simeste/IQRF-Smart-City/README.md

# IQRF Smart City / Smartby
IQRF Smart City prosjekt på NTNU i Gjøvik.

Les manualen for å forstå hvordan byen fungerer.
