simeste/IQRF-Smart-City/Streetlights/Circuit/pcb/pdf.pdf

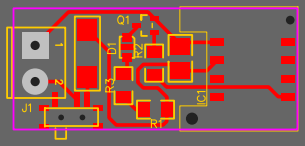
[picture p1: figure]
