simeste/IQRF-Smart-City/Trafficlights/Circuit/EW - 1SHR/pcb/dxf.dxf

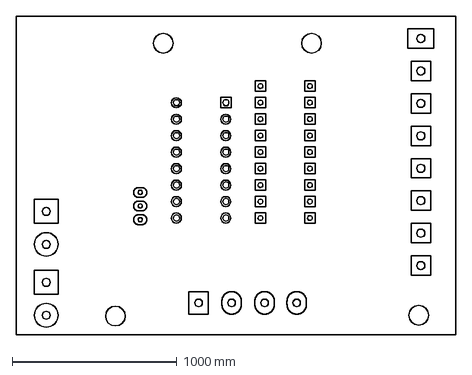
[picture p2: CAD file, 2019-11-27]
Trafficlights/Circuit/EW - 1SHR/pcb/dxf.dxf
2669.0 x 1930.0 mm
