simeste/IQRF-Smart-City/Trafficlights/Circuit/NS - 2SHR/pcb/dxf.dxf

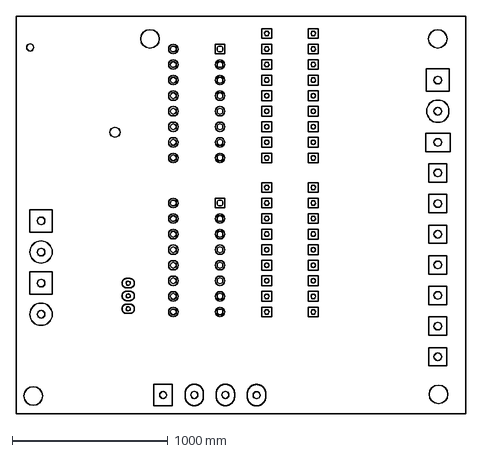
[picture p3: CAD file, 2019-11-27]
Trafficlights/Circuit/NS - 2SHR/pcb/dxf.dxf
2890.0 x 2556.0 mm
