simeste/IQRF-Smart-City/Doorlock/Circuit/pcb/dxf.dxf

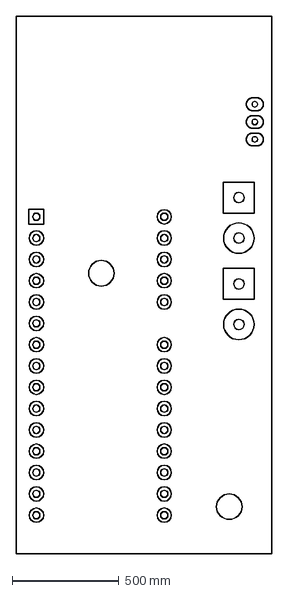
[picture p4: CAD file, 2019-11-27, an earlier design]
Doorlock/Circuit/pcb/dxf.dxf
1200.0 x 2520.0 mm
