simeste/IQRF-Smart-City/Parking Lot/Screen/Circuit/pcb/dxf.dxf

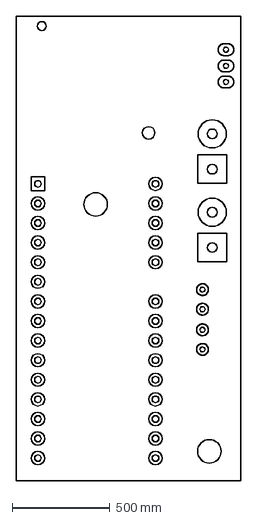
[picture p5: CAD file, 2019-11-27, an earlier design]
Parking Lot/Screen/Circuit/pcb/dxf.dxf
1145.0 x 2370.0 mm
