simeste/IQRF-Smart-City/Parking Lot/Space/Circuit/pcb/dxf.dxf

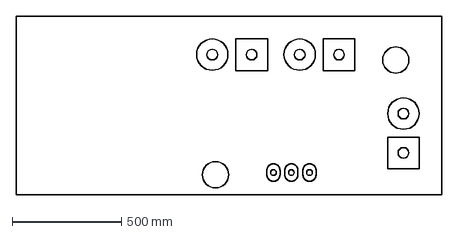
[picture p6: CAD file, 2019-11-27, an earlier design]
Parking Lot/Space/Circuit/pcb/dxf.dxf
1949.0 x 818.0 mm
