simeste/IQRF-Smart-City/Streetlights/Circuit/pcb/dxf.dxf

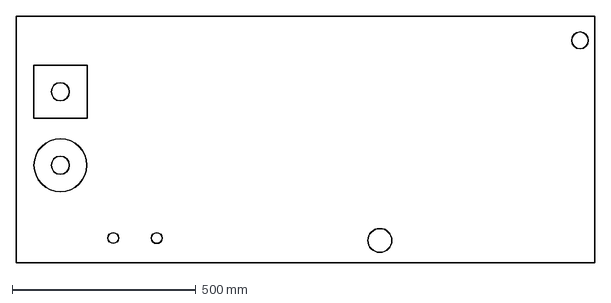
[picture p7: CAD file, 2019-11-27, an earlier design]
Streetlights/Circuit/pcb/dxf.dxf
1575.0 x 670.0 mm
