simeste/IQRF-Smart-City/Temperature Room/Circuit/pcb/Temperature sensor/dxf.dxf

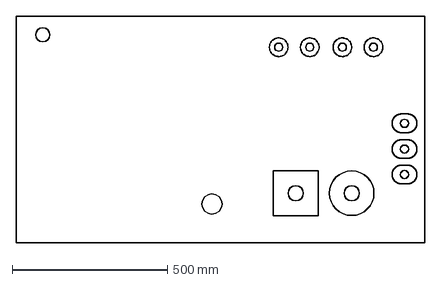
[picture p8: CAD file, 2019-11-27, an earlier design]
Temperature Room/Circuit/pcb/Temperature sensor/dxf.dxf
1315.0 x 730.0 mm
