simeste/IQRF-Smart-City/Trafficlights/Circuit/EW - 1SHR/schematics/pdf.pdf

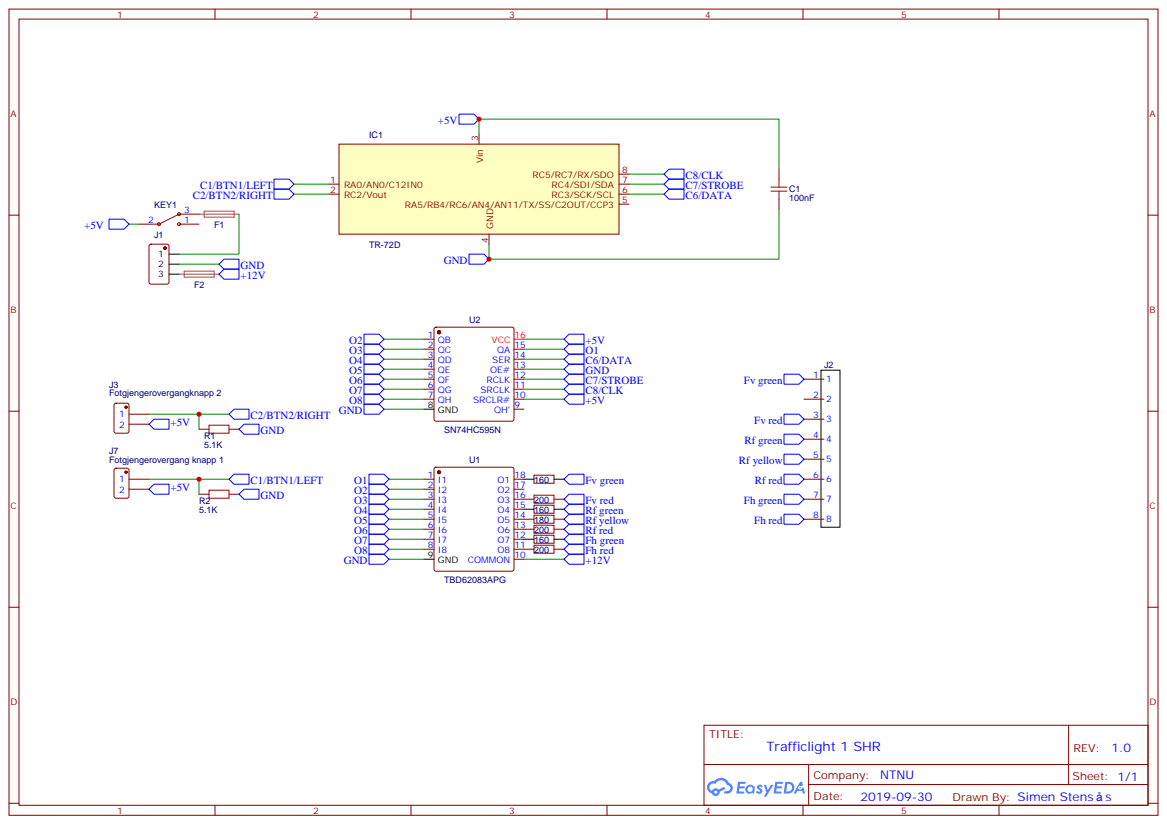
[picture p19: page 1]

SRCLR# 10 SRCLK 11 RCLK 12 OE# 13 SER 14 QA 15 VCC 16

Drawn By: Simen Stens s
