simeste/IQRF-Smart-City/Trafficlights/Circuit/EW - 1SHR/pcb/pdf.pdf

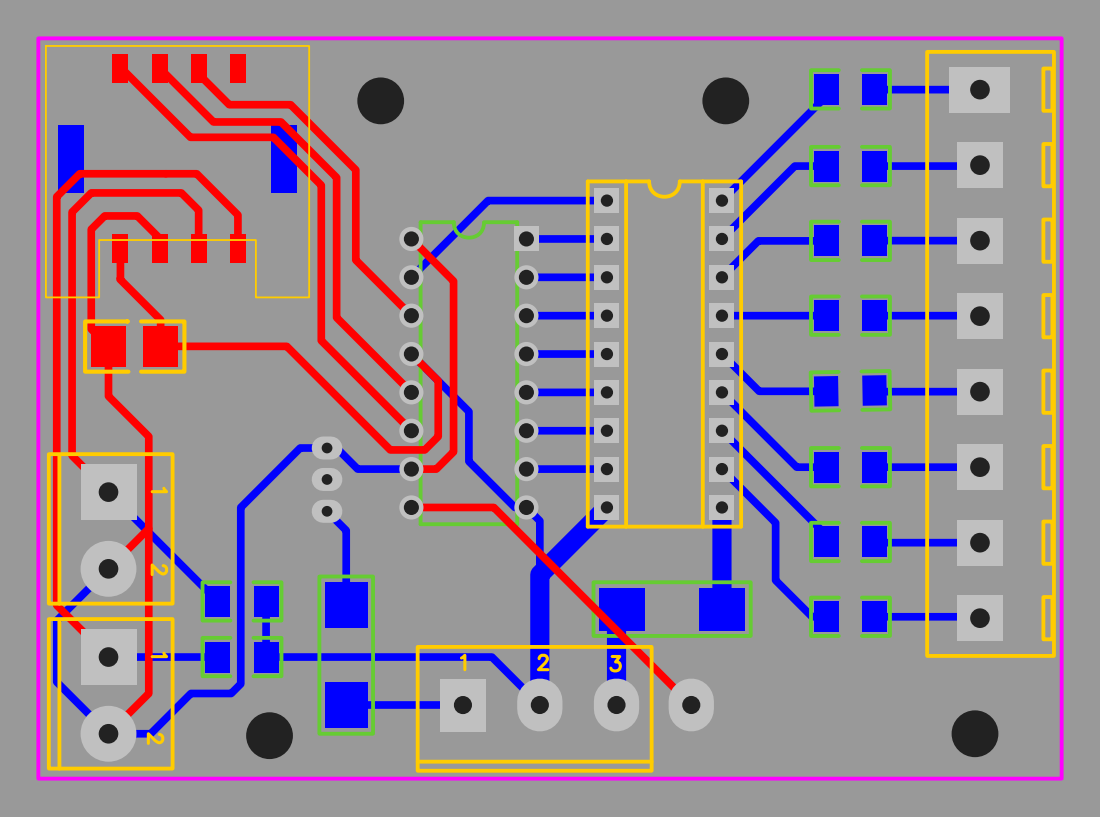
[picture p20: page 1]
