simeste/IQRF-Smart-City/Trafficlights/Circuit/EW - 1SHR/pcb/pdf_bottom.pdf

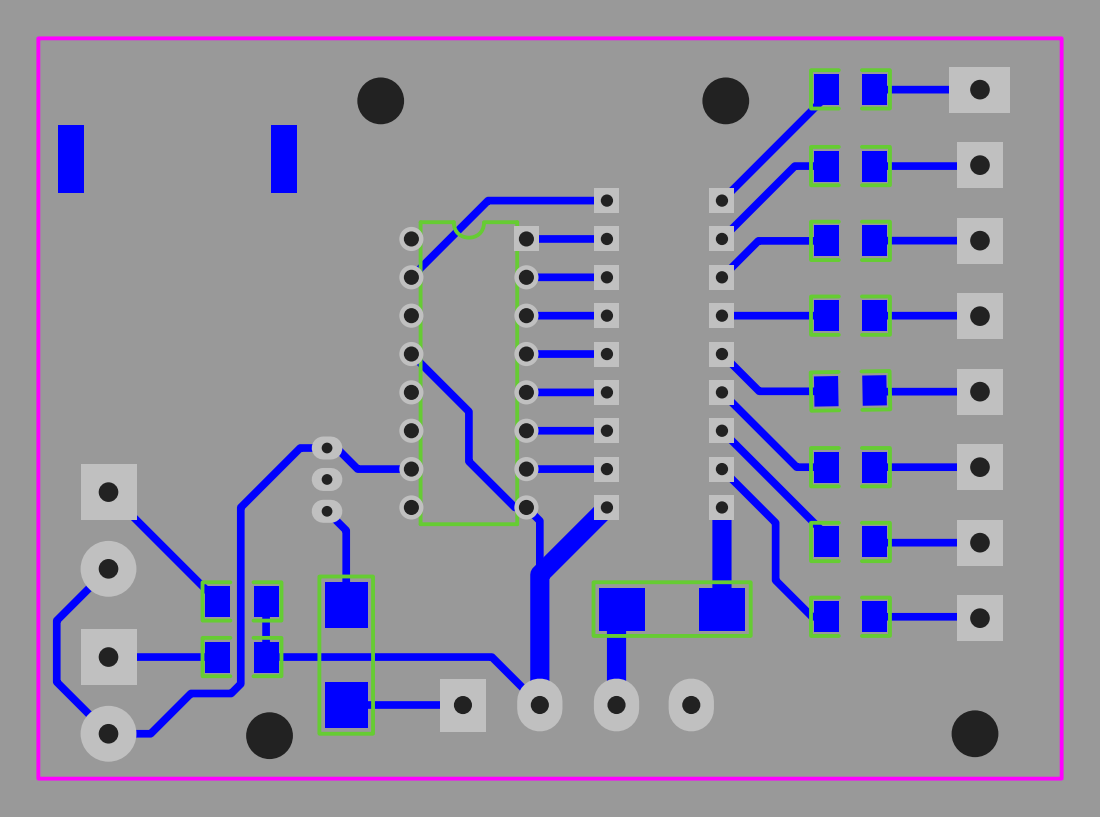
[picture p21: page 1]
