simeste/IQRF-Smart-City/Trafficlights/Circuit/EW - 1SHR/pcb/pdf_top.pdf

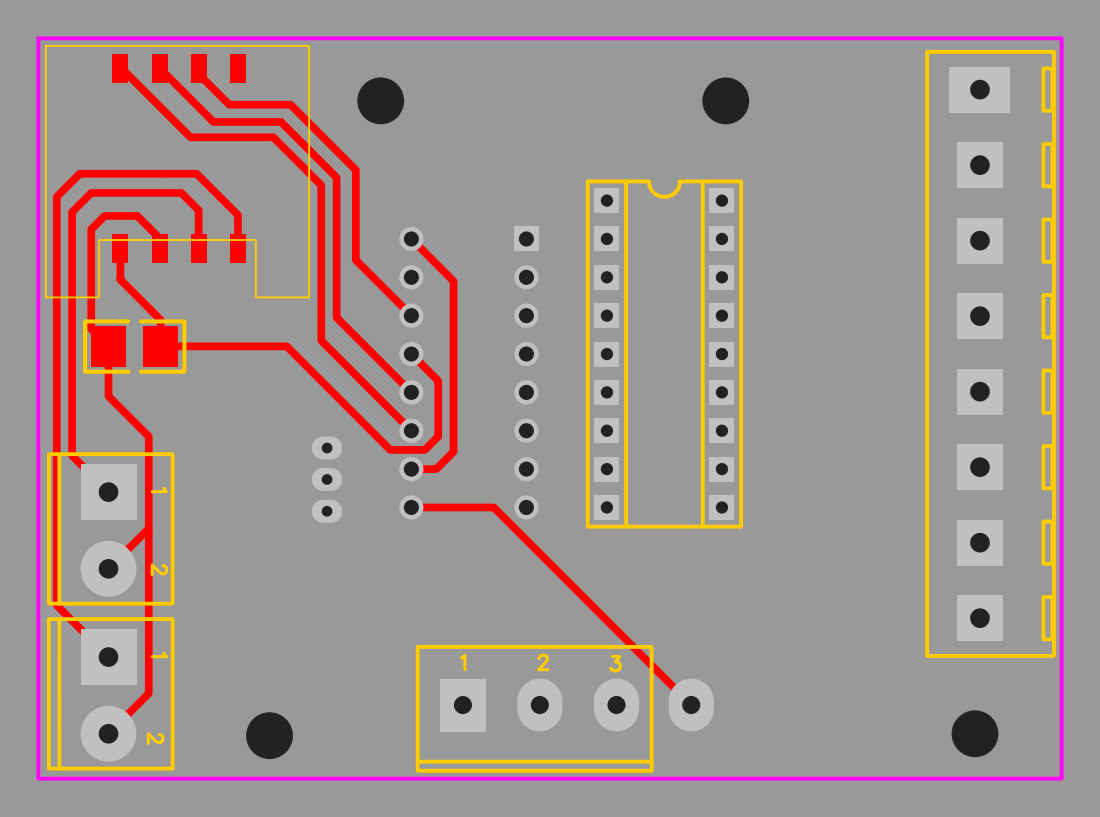
[picture p22: page 1]
