simeste/IQRF-Smart-City/Trafficlights/Circuit/NS - 2SHR/pcb/pdf.pdf

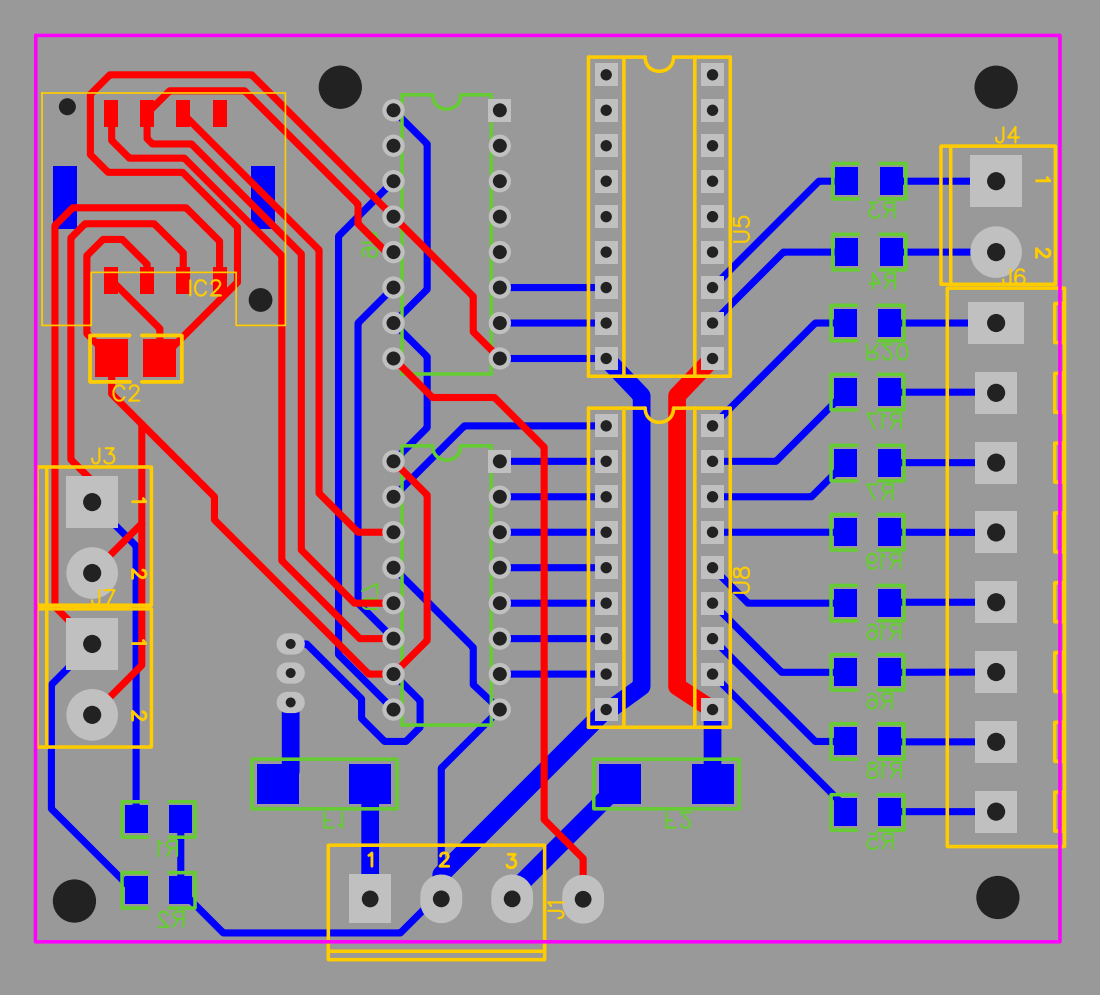
[picture p23: page 1]
