simeste/IQRF-Smart-City/Trafficlights/Circuit/NS - 2SHR/pcb/pdf_bottom.pdf

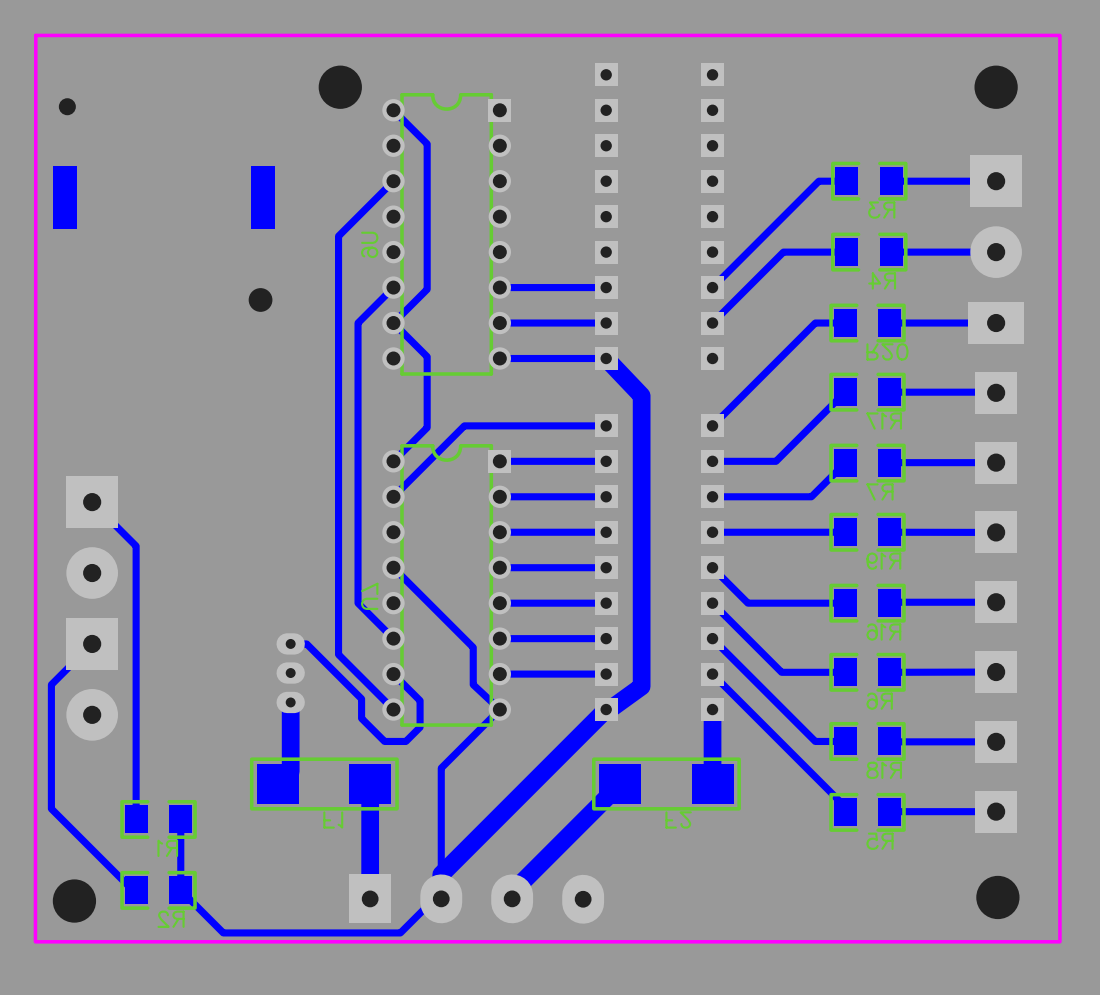
[picture p24: page 1]
