simeste/IQRF-Smart-City/Trafficlights/Circuit/NS - 2SHR/pcb/pdf_top.pdf

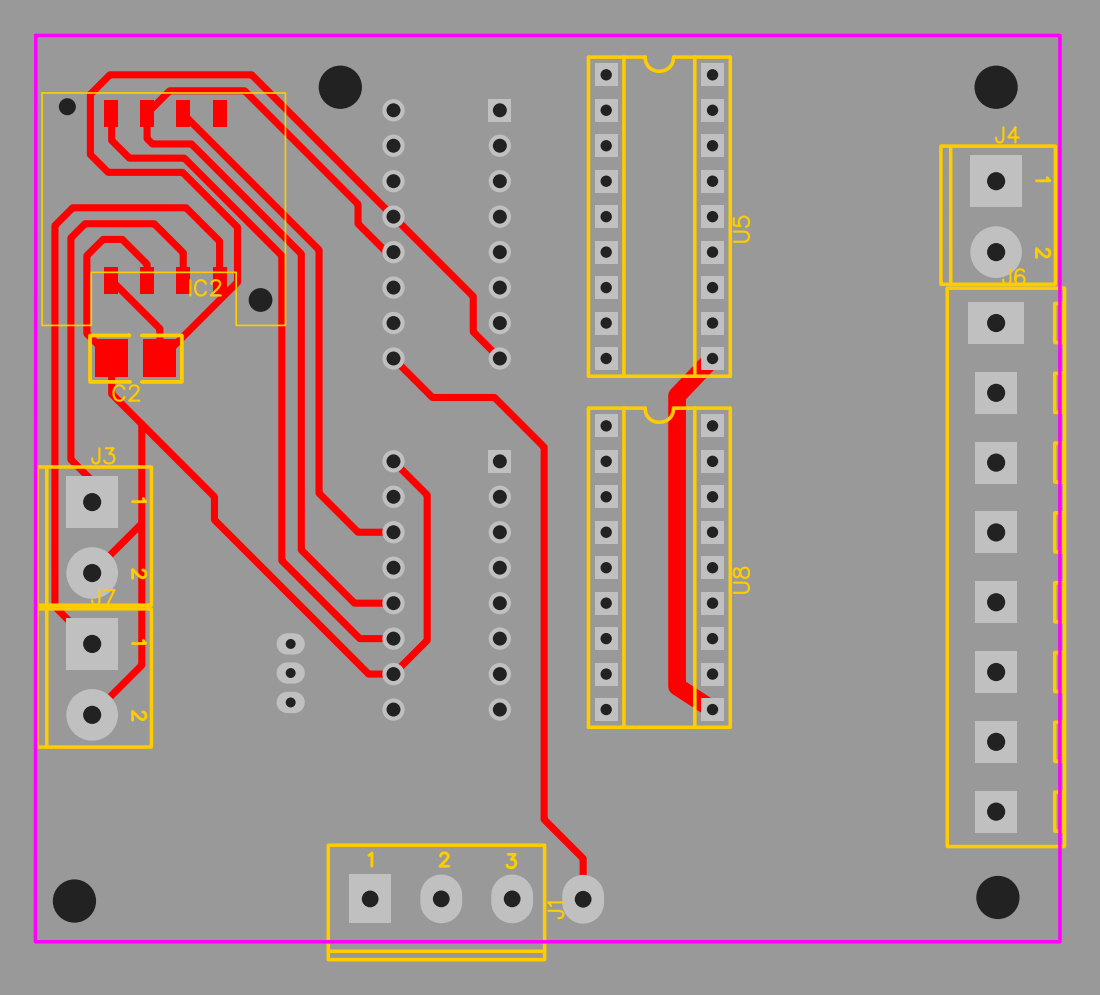
[picture p25: page 1]
