simeste/IQRF-Smart-City/Doorlock/Circuit/schematics/pdf.pdf

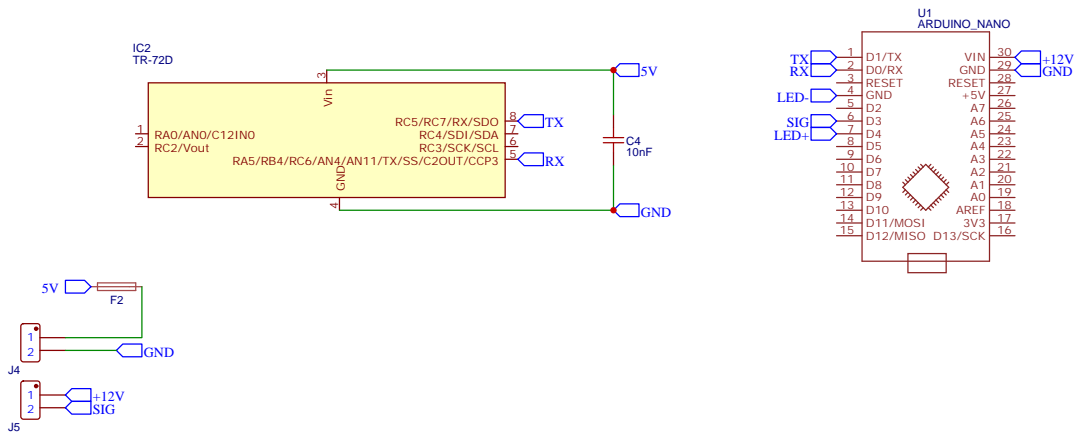
[picture p26: page 1]

Drawn By: Simen Stens s
