simeste/IQRF-Smart-City/Streetlights/Circuit/schematics/pdf.pdf

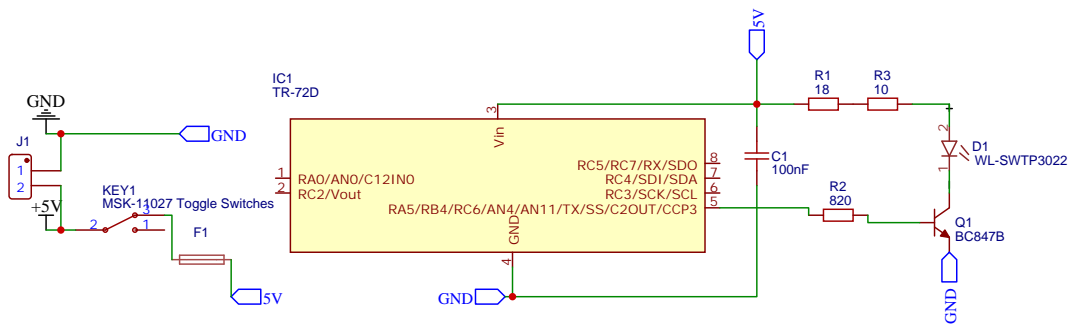
[picture p27: page 1]

Drawn By: Simen Stens s
