simeste/IQRF-Smart-City/Parking Lot/Screen/Circuit/schematics/pdf.pdf

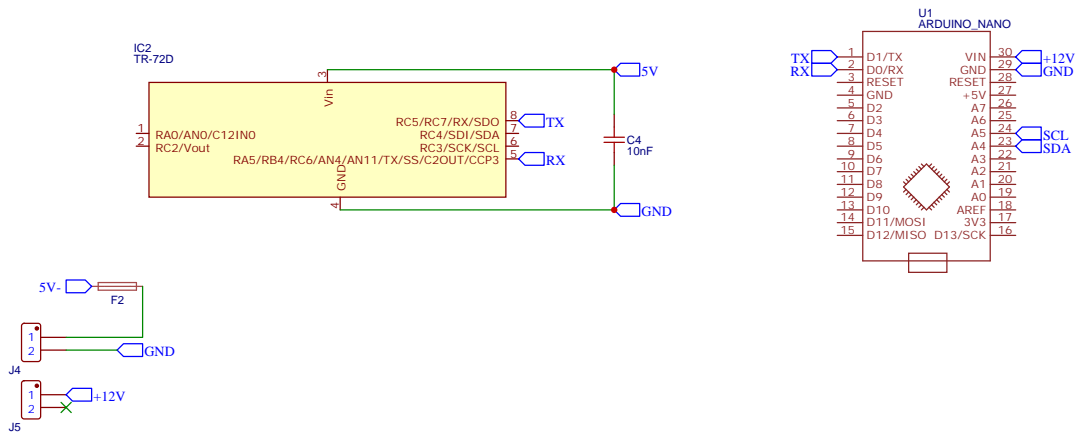
[picture p28: page 1]

Drawn By: Simen Stens s
