simeste/IQRF-Smart-City/Parking Lot/Space/Circuit/schematics/pdf.pdf

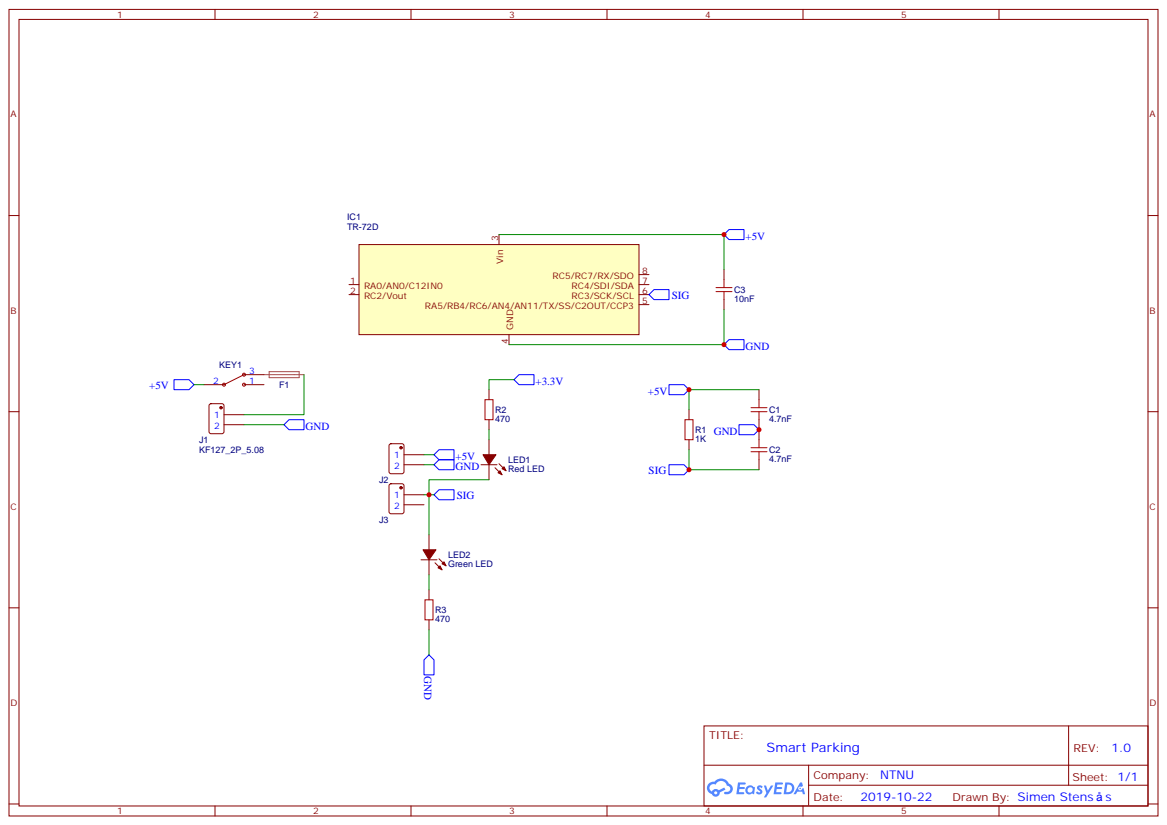
[picture p29: page 1]

Drawn By: Simen Stens s
