simeste/IQRF-Smart-City/Temperature Room/Circuit/schematics/Temperature sensor/pdf.pdf

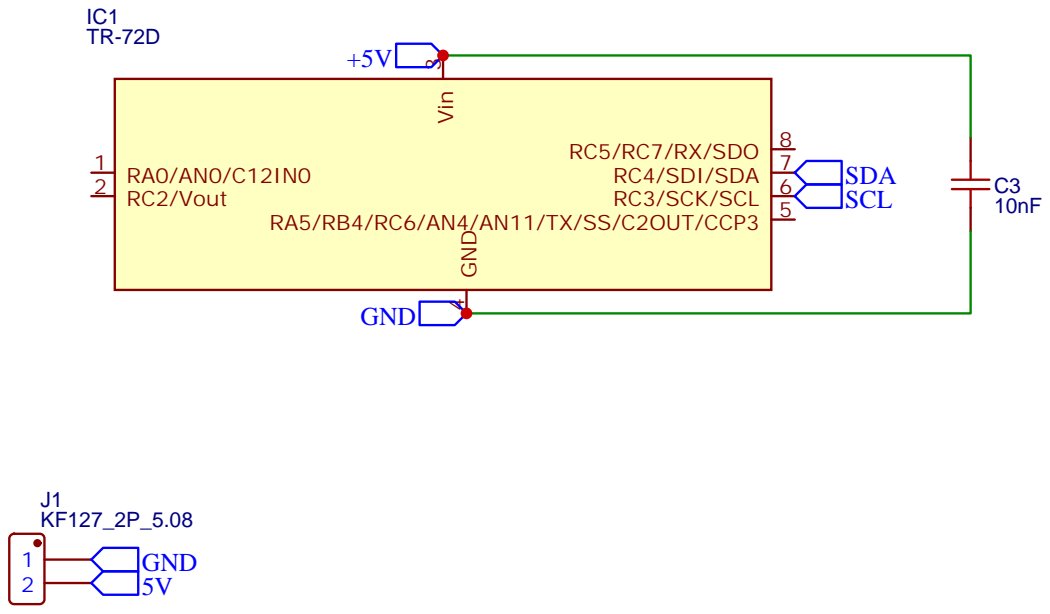
[picture p30: page 1]

Drawn By: Simen Stens s
