simeste/IQRF-Smart-City/Doorlock/Circuit/pcb/pdf.pdf

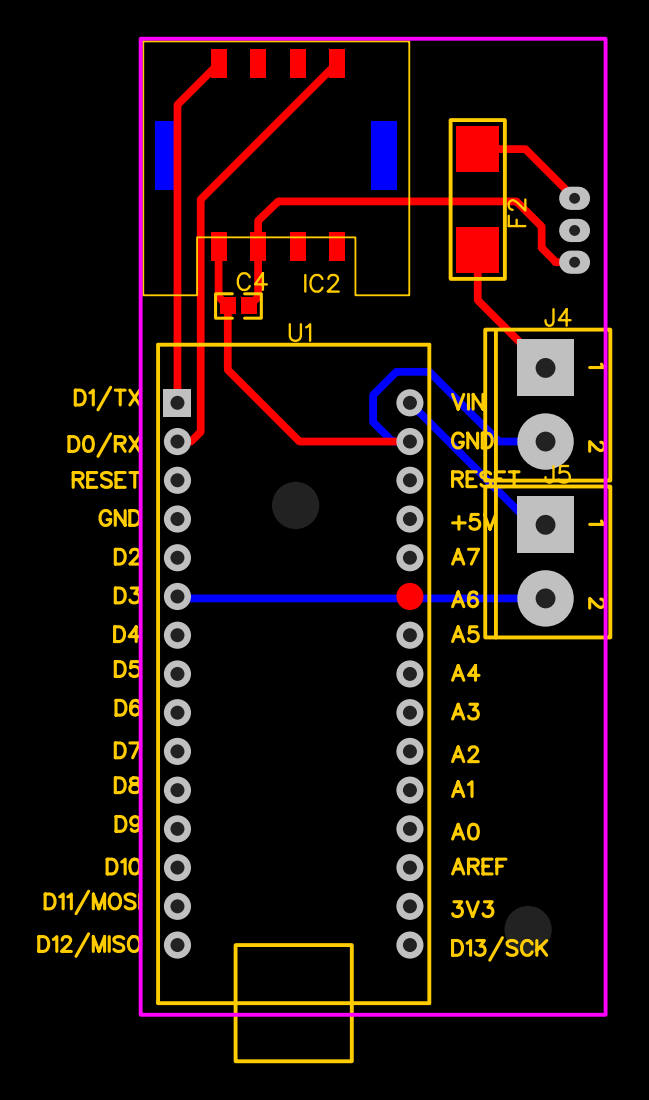
[picture p31: page 1]
