simeste/IQRF-Smart-City/Doorlock/Circuit/pcb/pdf_bottom.pdf

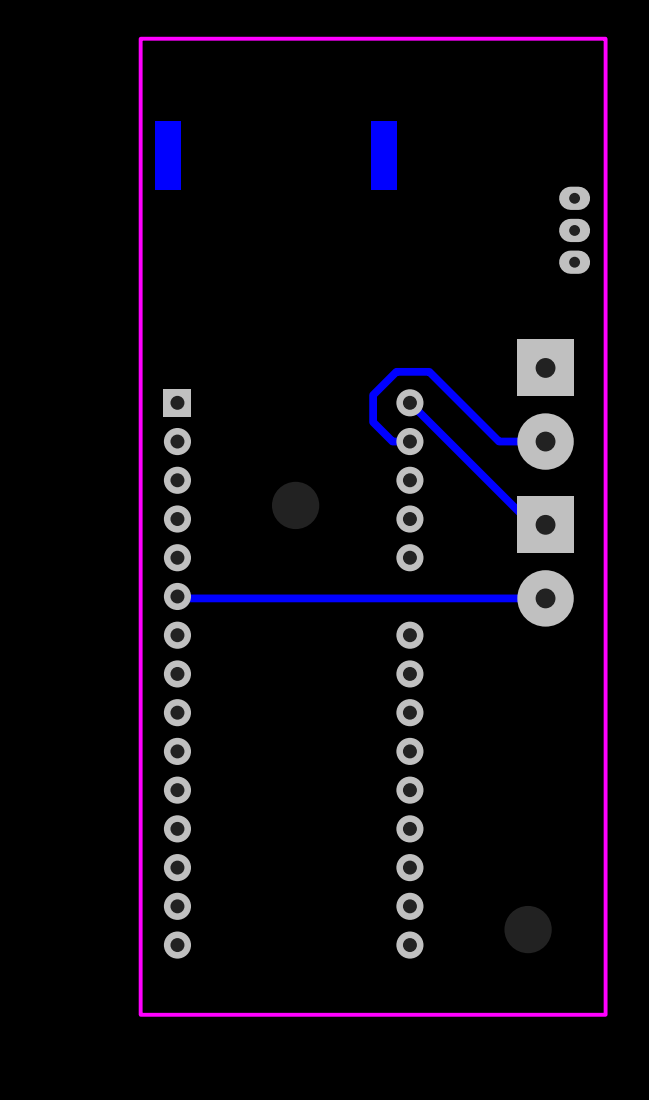
[picture p32: page 1]
