simeste/IQRF-Smart-City/Doorlock/Circuit/pcb/pdf_top.pdf

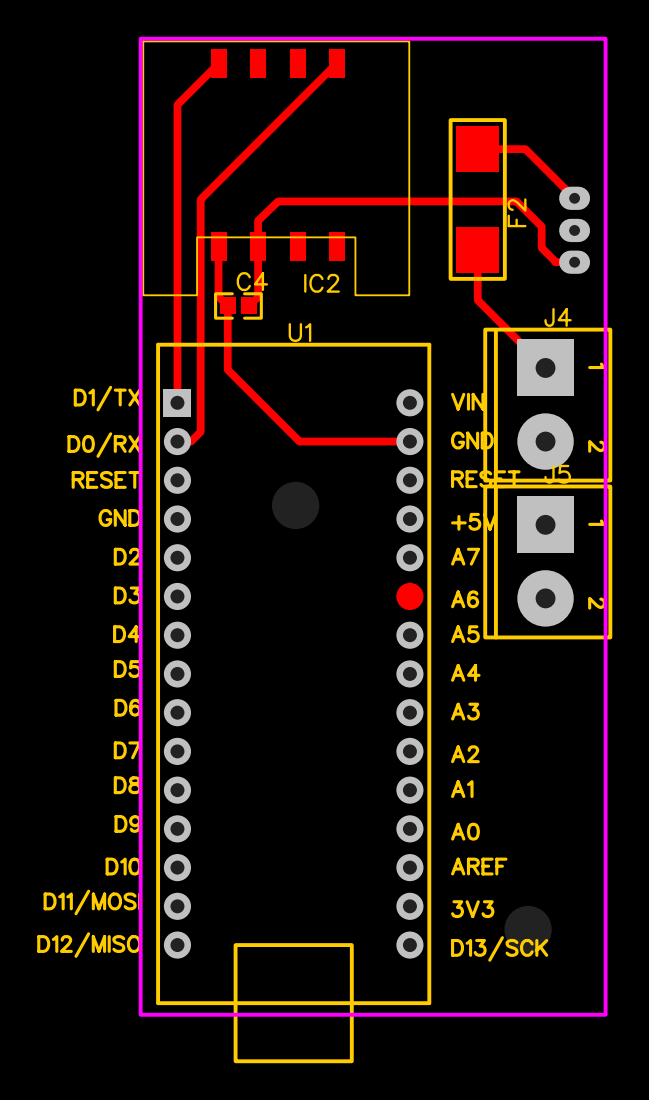
[picture p33: page 1]
