simeste/IQRF-Smart-City/Parking Lot/Screen/Circuit/pcb/pdf.pdf

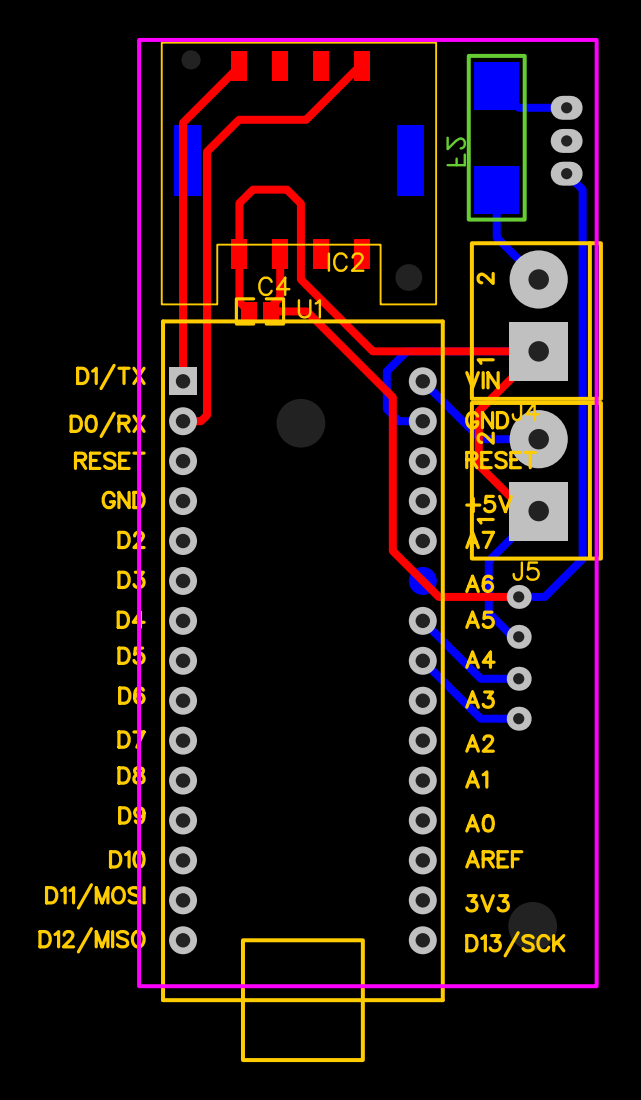
[picture p34: page 1]
