simeste/IQRF-Smart-City/Parking Lot/Screen/Circuit/pcb/pdf_bottom.pdf

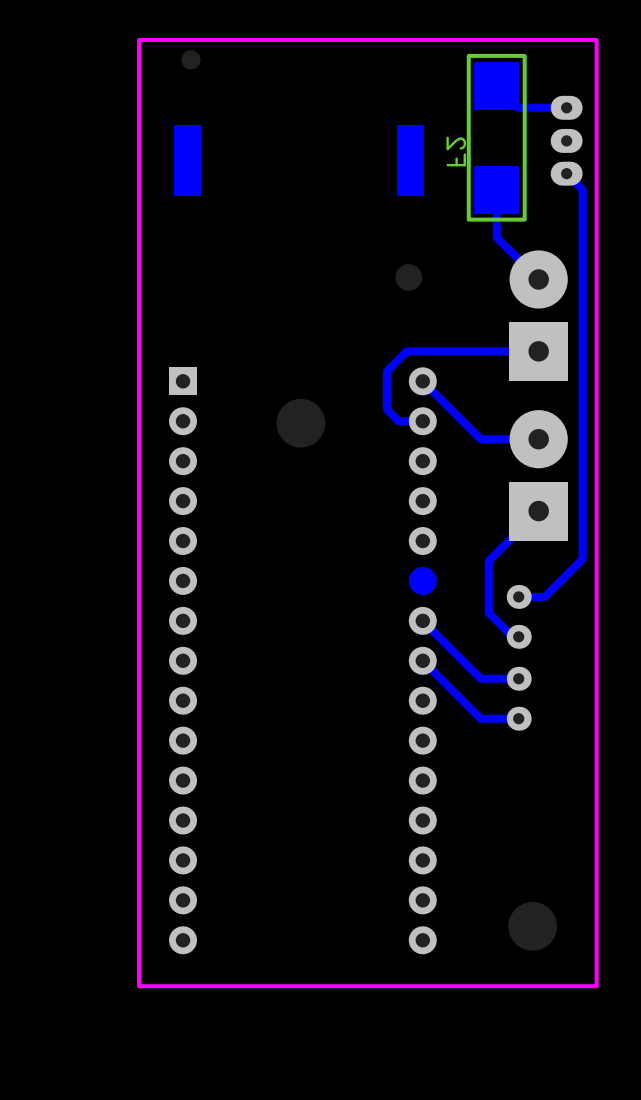
[picture p35: page 1]
