simeste/IQRF-Smart-City/Parking Lot/Screen/Circuit/pcb/pdf_top.pdf

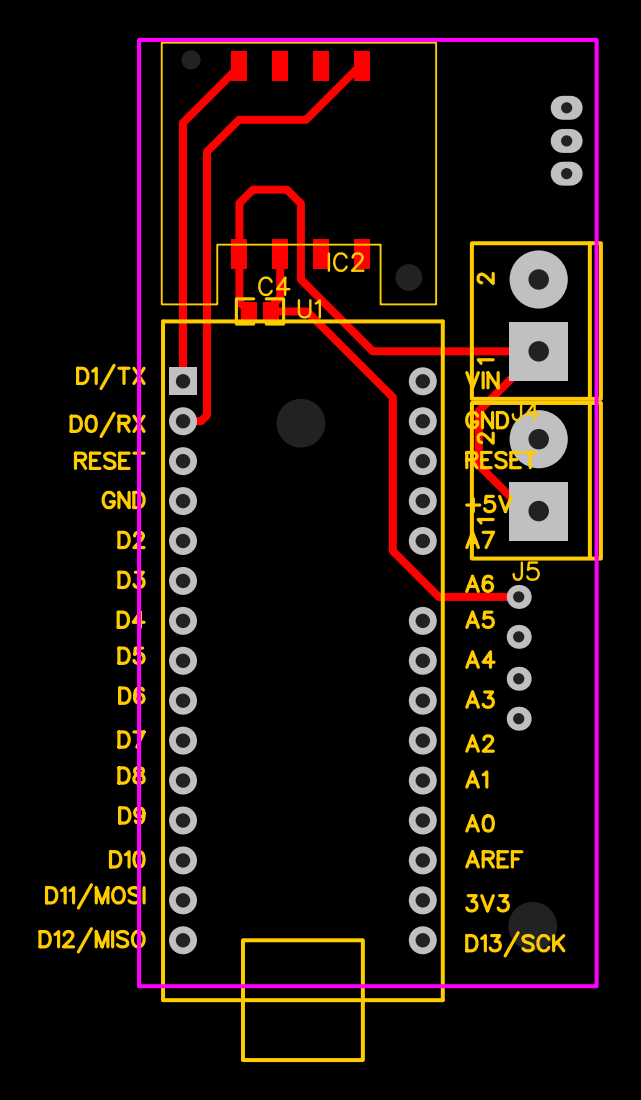
[picture p36: page 1]
