simeste/IQRF-Smart-City/Parking Lot/Space/Circuit/pcb/pdf.pdf

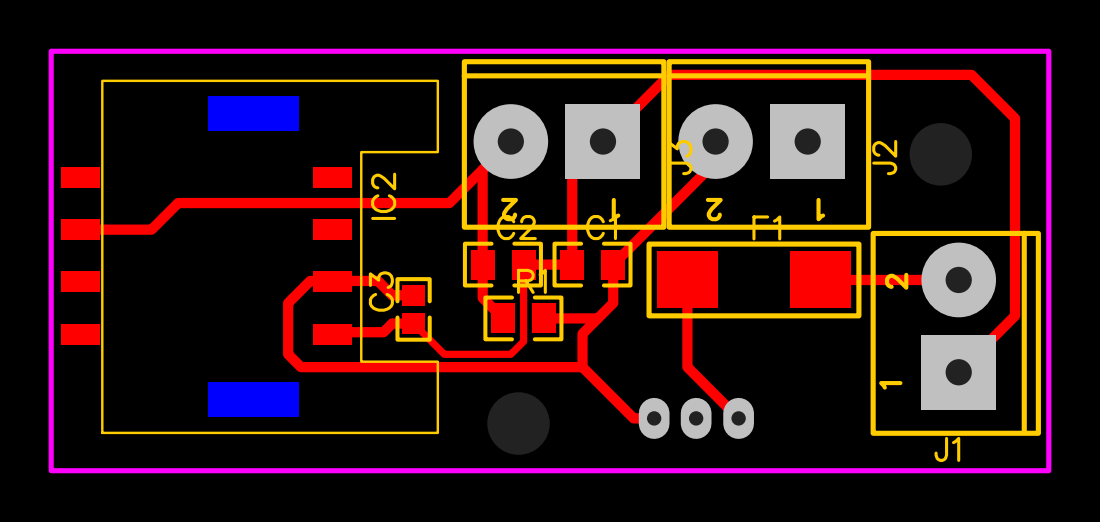
[picture p37: page 1]
