simeste/IQRF-Smart-City/Parking Lot/Space/Circuit/pcb/pdf_bottom.pdf

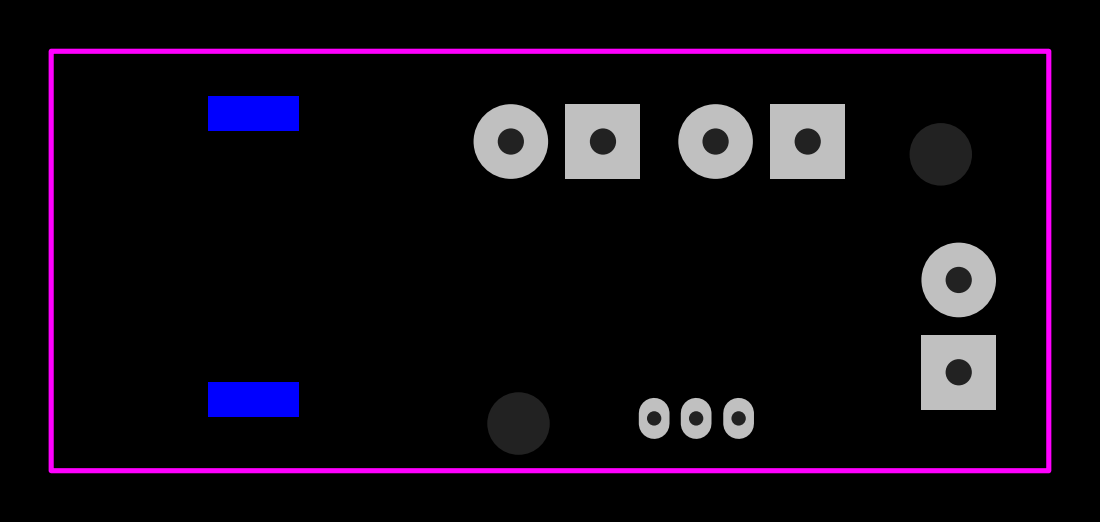
[picture p38: page 1]
