simeste/IQRF-Smart-City/Parking Lot/Space/Circuit/pcb/pdf_top.pdf

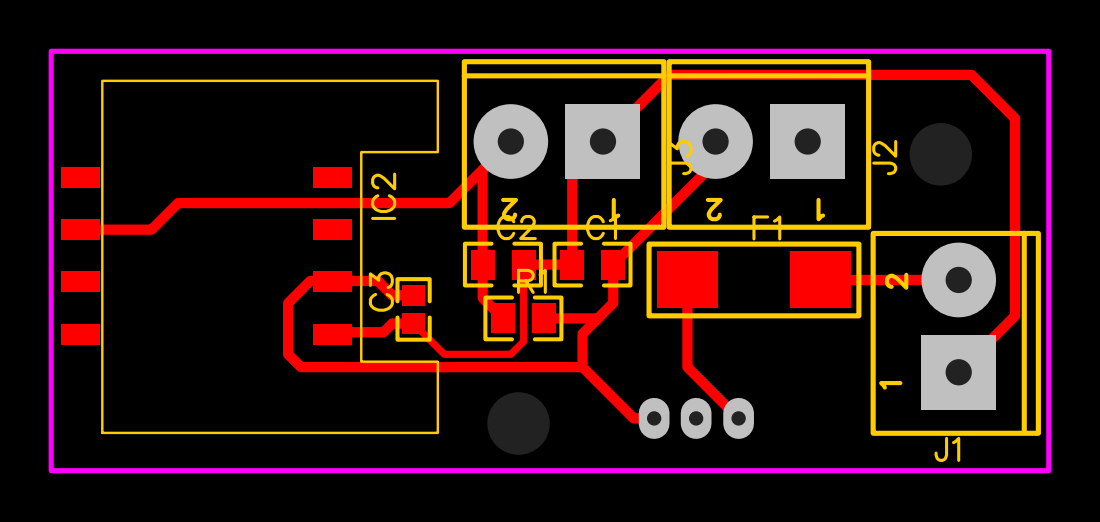
[picture p39: page 1]
