simeste/IQRF-Smart-City/Temperature Room/Circuit/pcb/Temperature sensor/pdf.pdf

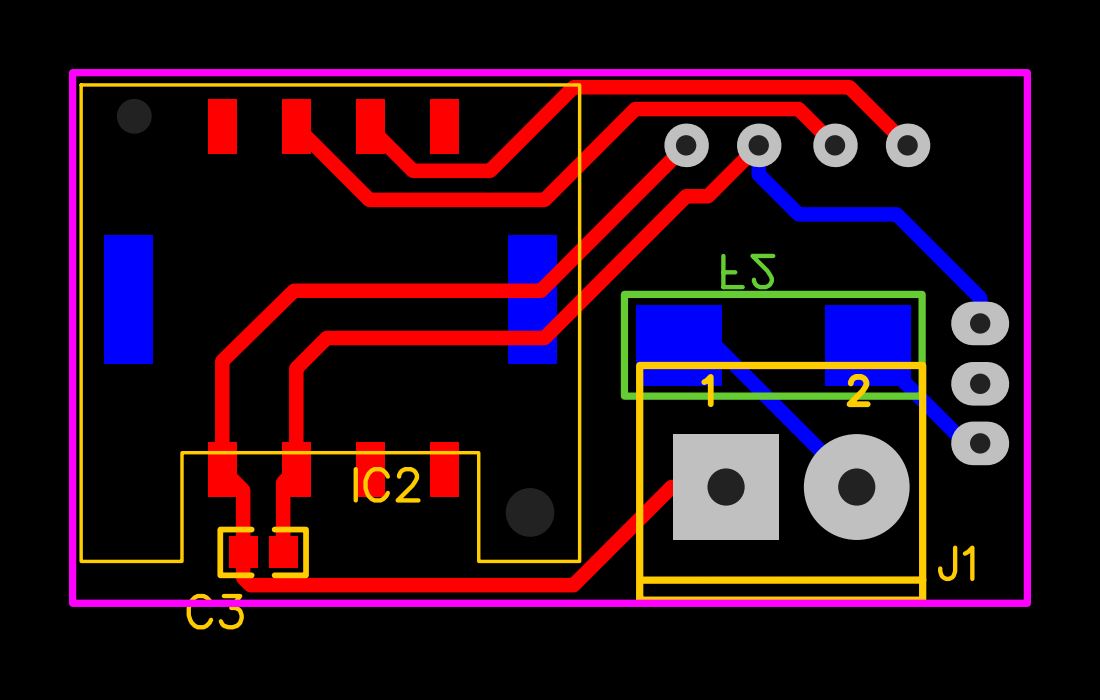
[picture p40: page 1]
