simeste/IQRF-Smart-City/Temperature Room/Circuit/pcb/Temperature sensor/pdf_bottom.pdf

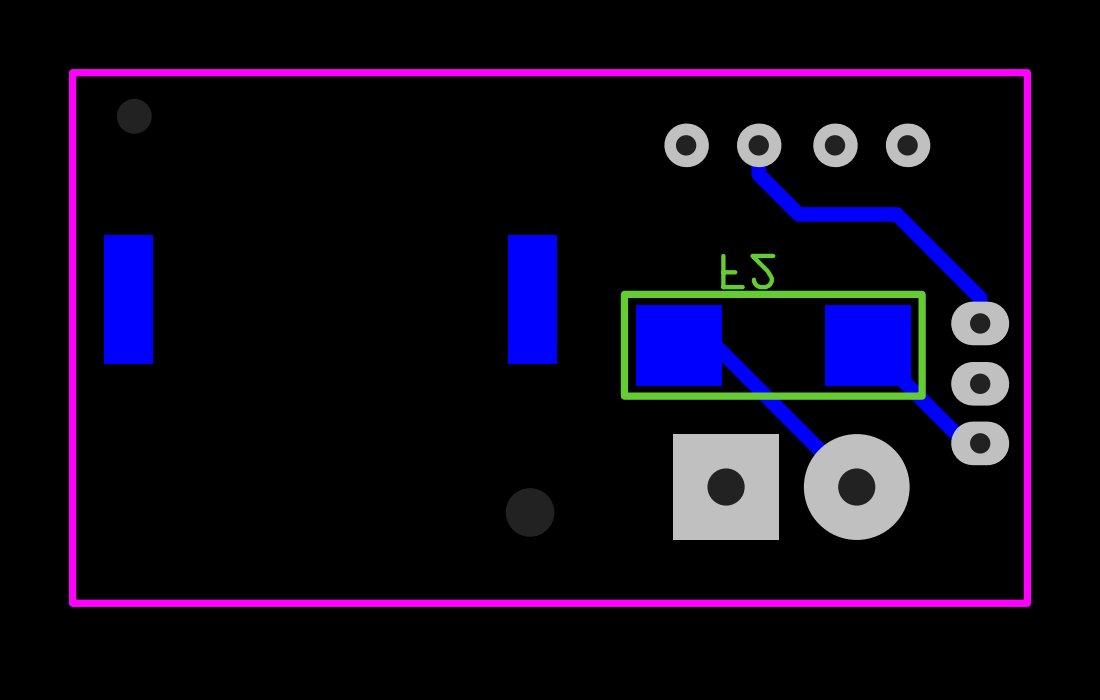
[picture p41: page 1]
