simeste/IQRF-Smart-City/Temperature Room/Circuit/pcb/Temperature sensor/pdf_top.pdf

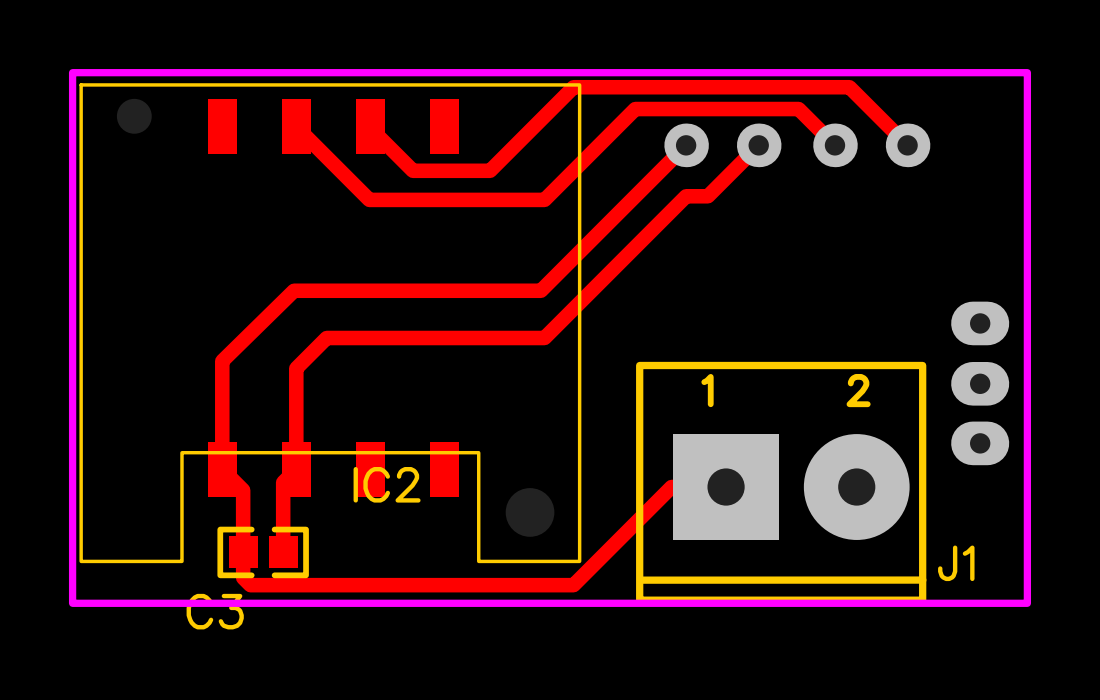
[picture p42: page 1]
