simeste/IQRF-Smart-City/(list of files, drawings)

Other design files:
Doorlock/Circuit/pcb/altium.pcbdoc
Doorlock/Circuit/pcb/easyeda.json
Doorlock/Circuit/schematics/altium.schdoc
Doorlock/Circuit/schematics/easyeda.json
Parking Lot/Screen/Circuit/pcb/altium.pcbdoc
Parking Lot/Screen/Circuit/pcb/easyeda.json
Parking Lot/Screen/Circuit/schematics/altium.schdoc
Parking Lot/Screen/Circuit/schematics/easyeda.json
Parking Lot/Space/Circuit/pcb/altium.pcbdoc
Parking Lot/Space/Circuit/pcb/easyeda.json
Parking Lot/Space/Circuit/schematics/altium.schdoc
Parking Lot/Space/Circuit/schematics/easyeda.json
Parking Lot/Space/Circuit/schematics/TLE4905L koblingsskjema.ms14
Streetlights/Circuit/pcb/altium.pcbdoc
Streetlights/Circuit/pcb/easyeda.json
Streetlights/Circuit/schematics/altium.schdoc
Streetlights/Circuit/schematics/easyeda.json
Temperature Room/Circuit/pcb/Temperature sensor/altium.pcbdoc
Temperature Room/Circuit/pcb/Temperature sensor/easyeda.json
Temperature Room/Circuit/schematics/multisim for resistor.ms14
Temperature Room/Circuit/schematics/Temperature sensor/altium.schdoc
Temperature Room/Circuit/schematics/Temperature sensor/easyeda.json
Trafficlights/Circuit/EW - 1SHR/pcb/altium.pcbdoc
Trafficlights/Circuit/EW - 1SHR/pcb/easyeda.json
Trafficlights/Circuit/EW - 1SHR/schematics/altium.schdoc
Trafficlights/Circuit/EW - 1SHR/schematics/easyeda.json
Trafficlights/Circuit/NS - 2SHR/pcb/altium.pcbdoc
Trafficlights/Circuit/NS - 2SHR/pcb/easyeda.json
Trafficlights/Circuit/NS - 2SHR/schematics/altium.schdoc
Trafficlights/Circuit/NS - 2SHR/schematics/easyeda.json
